faiyajr/75-ISO-Hall-Effect-Keyboard/AST1109MLTRQ_MAL.step

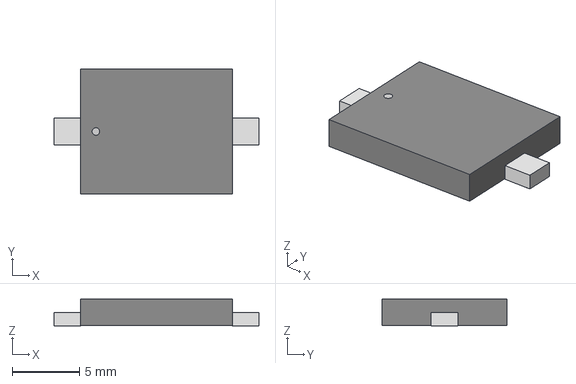
[picture p1: CAD file, 2026-01-05]
AST1109MLTRQ_MAL.step
15.3 x 9.30 x 2.01 mm
