faiyajr/75-ISO-Hall-Effect-Keyboard/Stabilizer - close.STEP

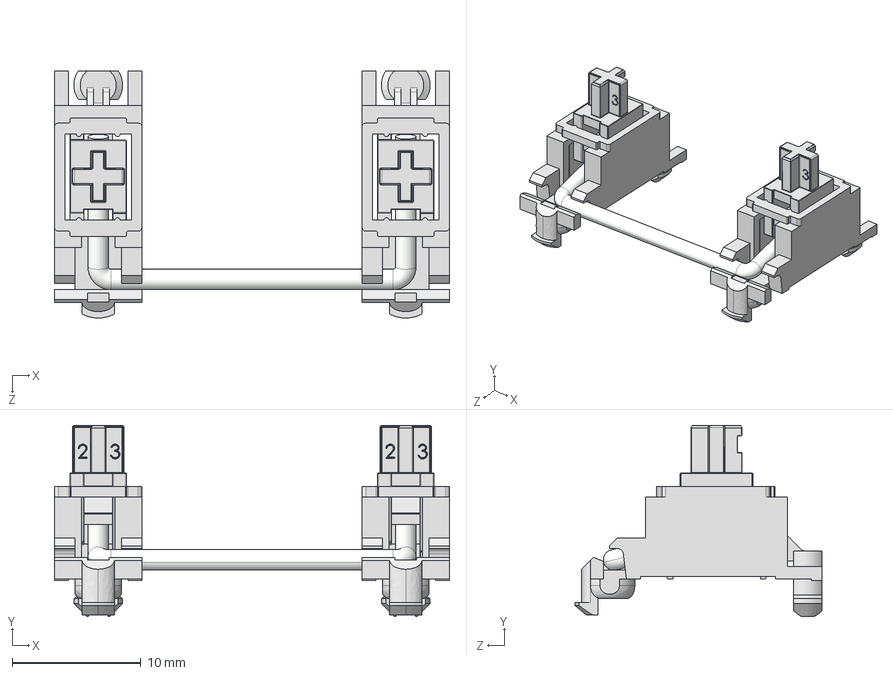
[picture p2: CAD file, 2026-01-05]
Stabilizer - close.STEP
30.7 x 14.9 x 19.2 mm
mx Stabilizer base 16828 x 2
mx Stabilizer key 16828 x 2
metal stick 16828
