faiyajr/75-ISO-Hall-Effect-Keyboard/HCM1206X.stp

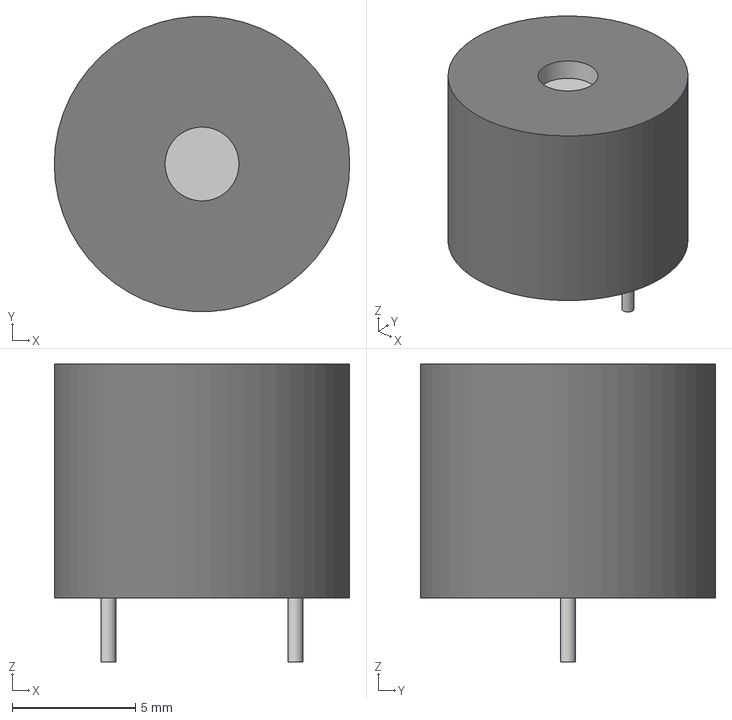
[picture p3: CAD file, 2026-01-05]
HCM1206X.stp
12.0 x 12.0 x 12.1 mm
