faiyajr/75-ISO-Hall-Effect-Keyboard/HRO  TYPE-C-31-M-12.step

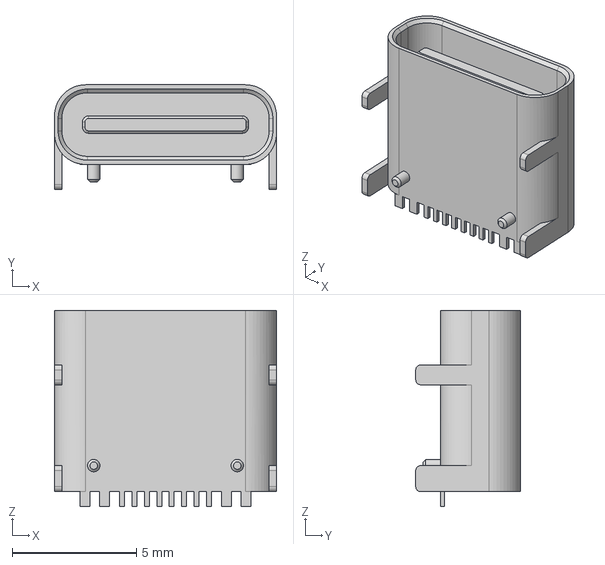
[picture p4: CAD file, 2026-01-05]
HRO TYPE-C-31-M-12.step
8.94 x 4.21 x 7.90 mm
