faiyajr/75-ISO-Hall-Effect-Keyboard/RKJXT1F42001.STEP

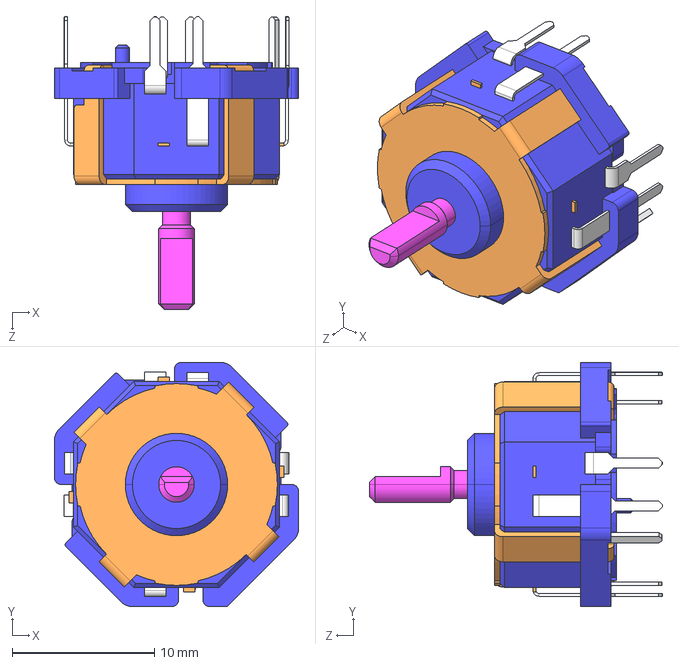
[picture p5: CAD file, 2026-01-05]
RKJXT1F42001.STEP
17.2 x 17.2 x 20.6 mm
