faiyajr/75-ISO-Hall-Effect-Keyboard/128x32-OLED.STEP

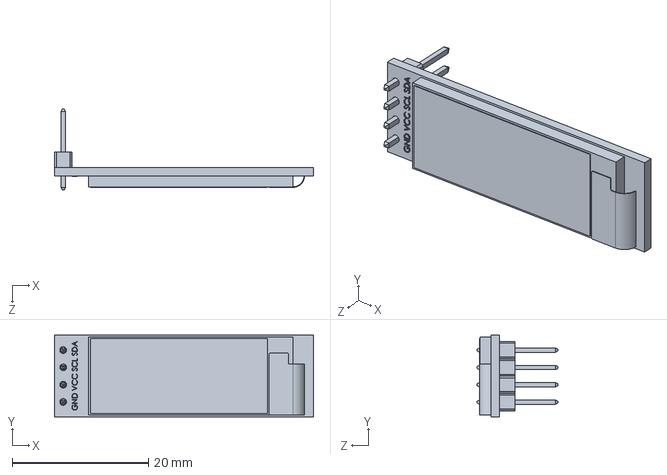
[picture p6: CAD file, 2026-01-05]
128x32-OLED.STEP
38.0 x 12.0 x 11.9 mm
