faiyajr/75-ISO-Hall-Effect-Keyboard/fahajedgecuts.dxf

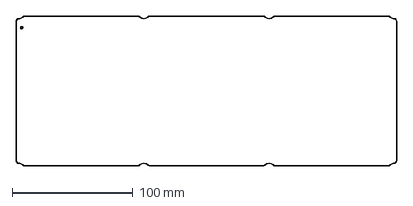
[picture p7: CAD file, 2026-01-05]
fahajedgecuts.dxf
314.3 x 123.8 mm
