faiyajr/75-ISO-Hall-Effect-Keyboard/keyboardcase.SLDPRT

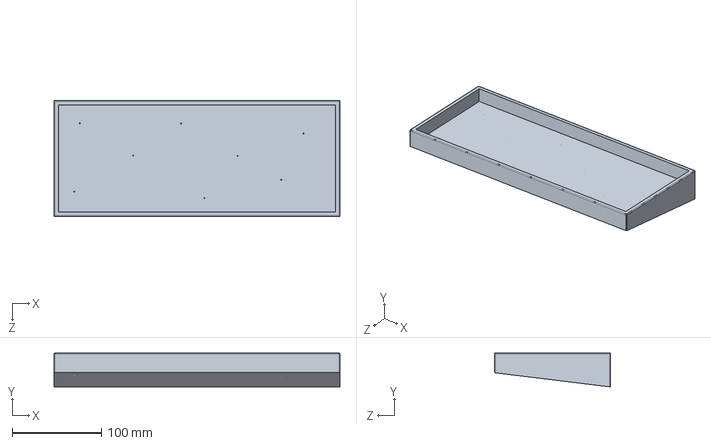
[picture p8: CAD file, 2026-01-05]
keyboardcase.SLDPRT
320.0 x 38.0 x 130.0 mm
