faiyajr/75-ISO-Hall-Effect-Keyboard/48393-0003.stp

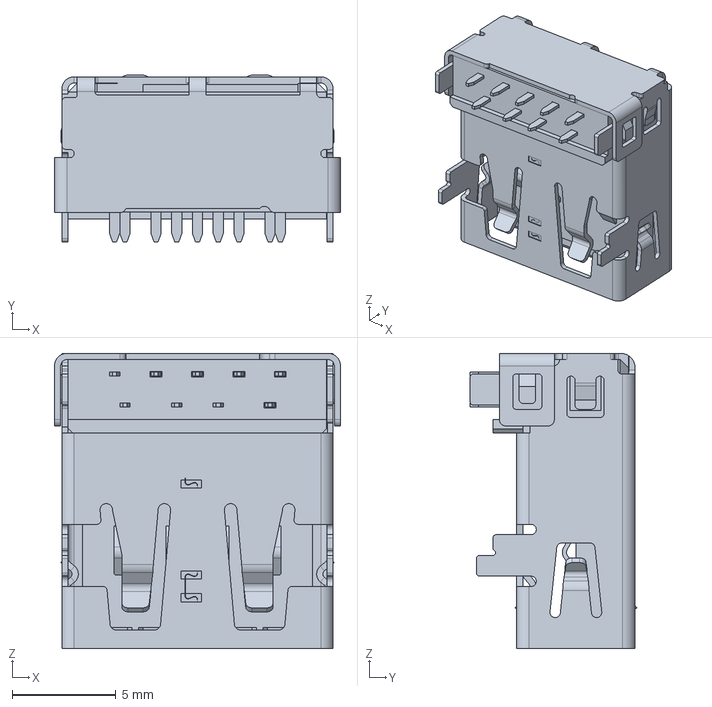
[picture p9: CAD file, 2026-01-05]
48393-0003.stp
13.8 x 8.04 x 14.3 mm
