faiyajr/75-ISO-Hall-Effect-Keyboard/0482580002.step

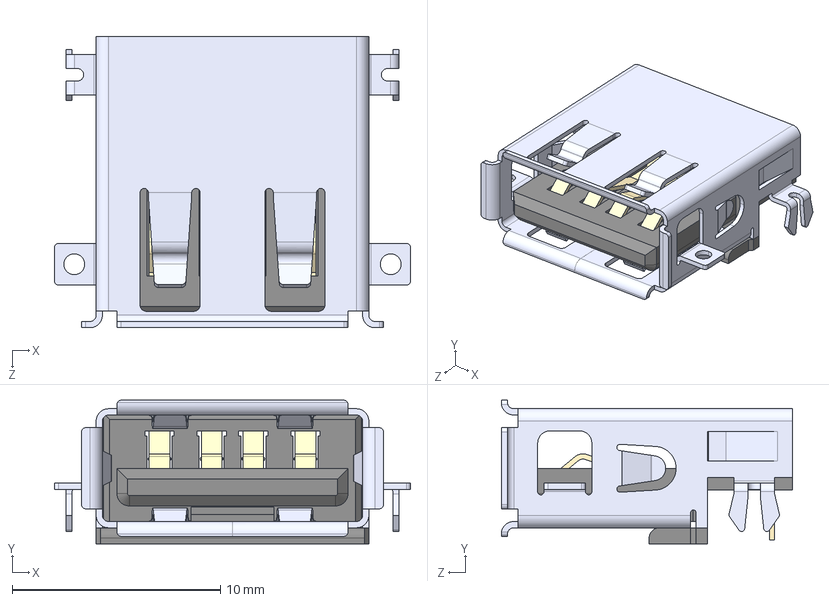
[picture p10: CAD file, 2026-01-05]
0482580002.step
17.1 x 6.90 x 14.0 mm
