faiyajr/75-ISO-Hall-Effect-Keyboard/78171-0004--3DModel-STEP-361473.STEP

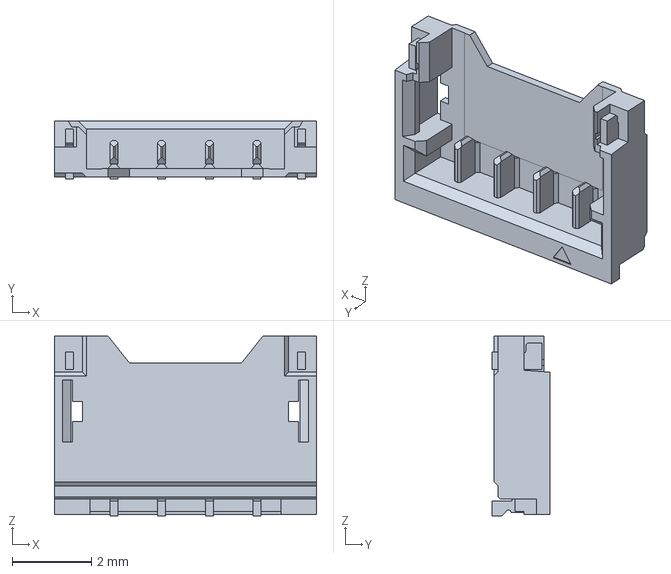
[picture p11: CAD file, 2026-01-05]
78171-0004--3DModel-STEP-361473.STEP
6.60 x 1.45 x 4.53 mm
