faiyajr/75-ISO-Hall-Effect-Keyboard/hall effect keyboard.kicad_sch

## KiCad design hall effect keyboard.kicad_sch (2026-01-05)

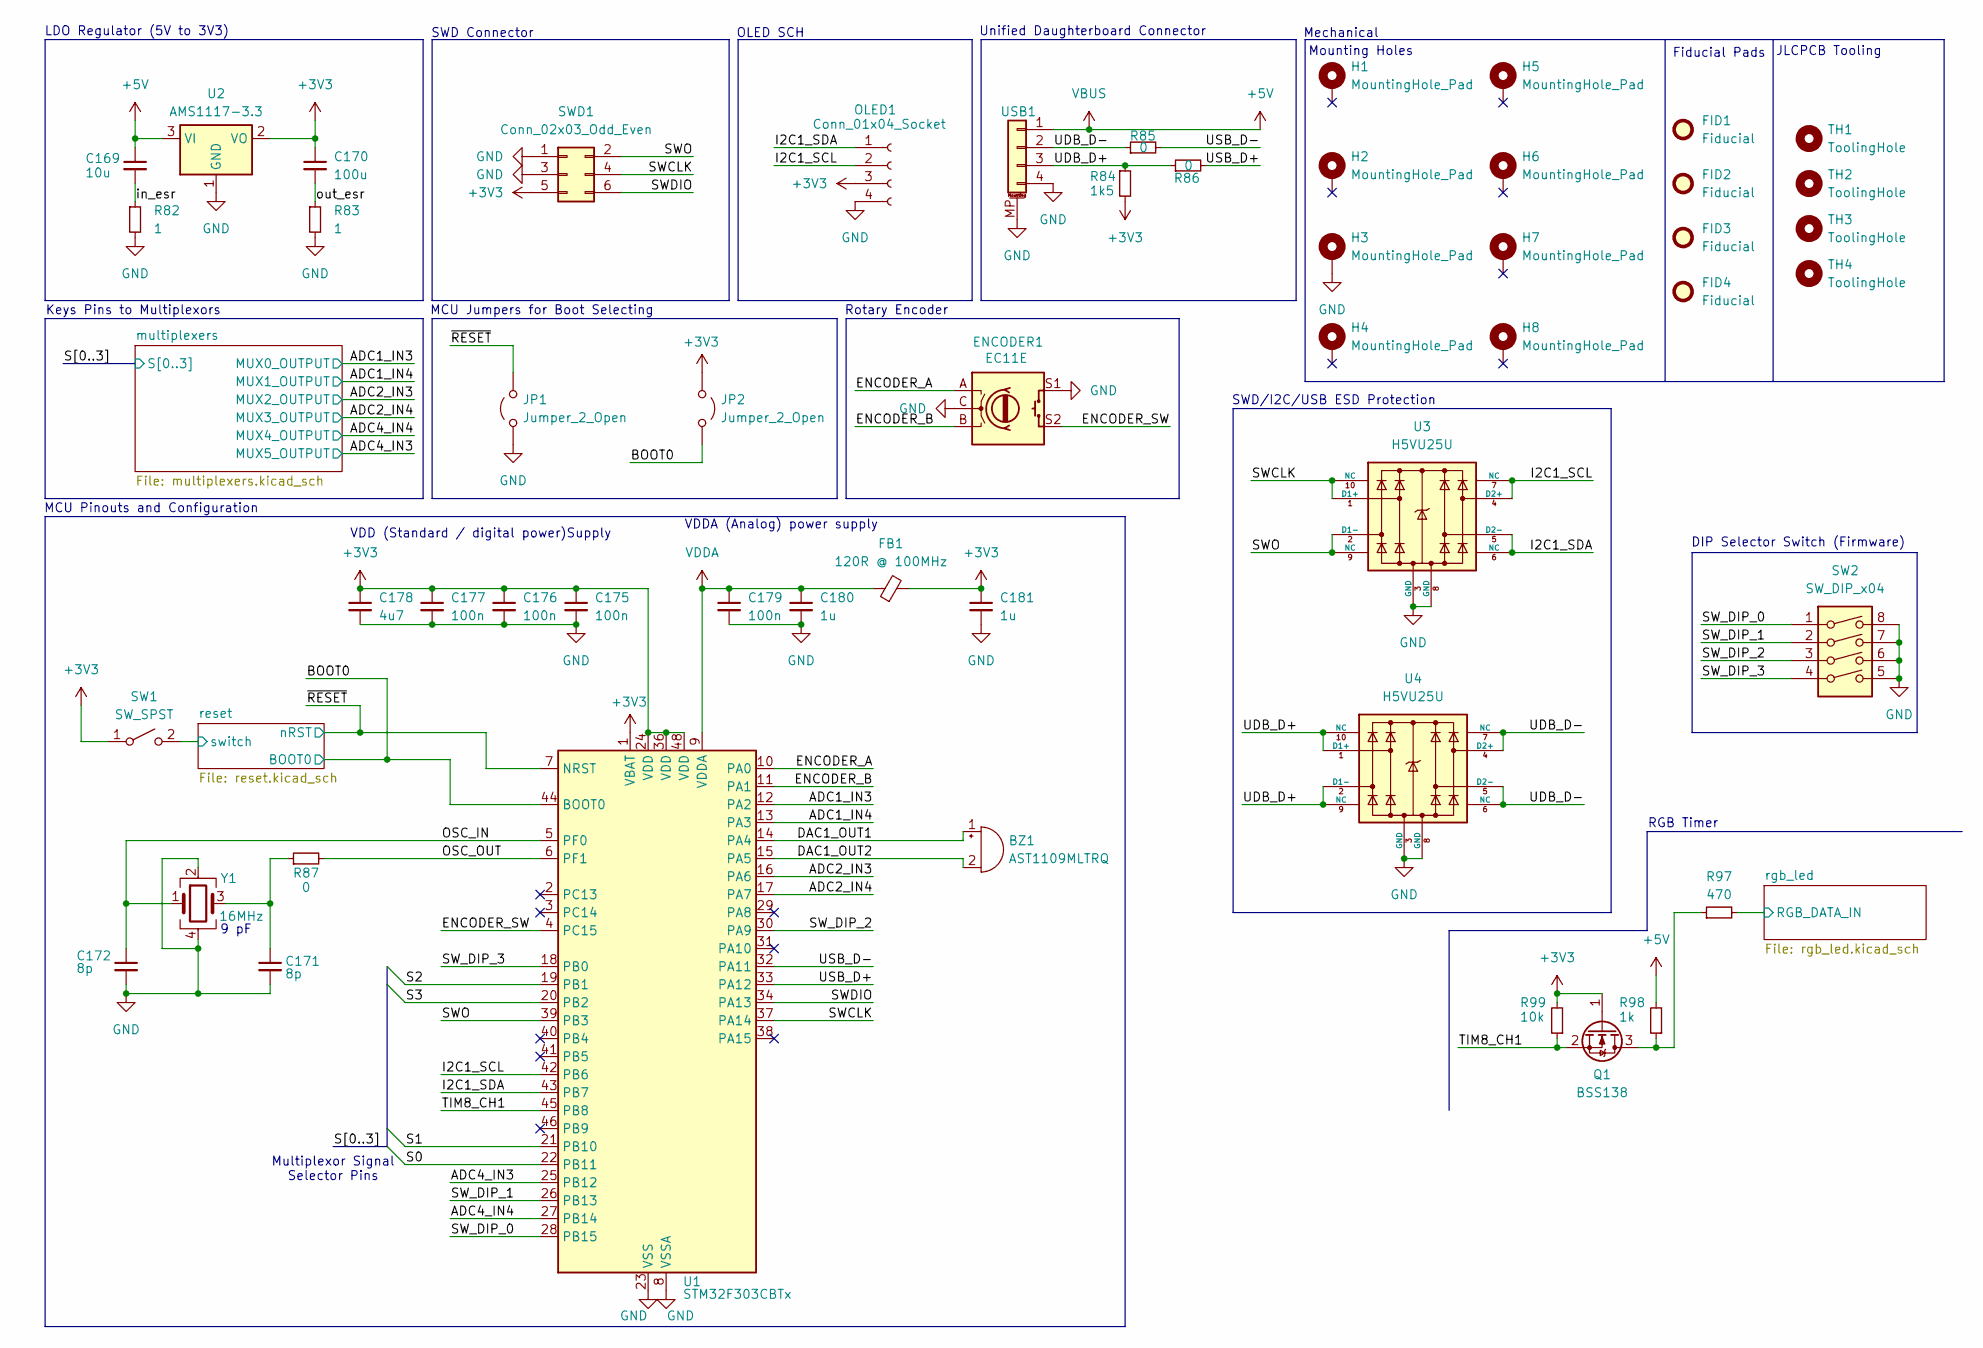
[picture p12: schematic hall effect keyboard.kicad_sch]

Parts:
BZ1: AST1109MLTRQ
C169: 10u; C_1206_3216Metric
C170: 100u; C_1206_3216Metric
C171, C172: 8p; C_0402_1005Metric
C175, C176, C177, C179: 100n; C_0402_1005Metric
C178: 4u7; C_0402_1005Metric
C180, C181: 1u; C_0402_1005Metric
ENCODER1: EC11E; ROT_Alps_EC11E-Switch
FB1: 120R @ 100MHz; L_0805_2012Metric
FID1, FID2, FID3, FID4: Fiducial; Fiducial_1mm_Mask2mm
H1, H2, H3, H4, H5, H6, H7, H8: MountingHole_Pad; 2.2mm hole
JP1, JP2: Jumper_2_Open; PinHeader_1x02_P2.54mm_Vertical
OLED1: Conn_01x04_Socket; OLED Module
Q1: BSS138; SOT-23
R82, R83: 1; R_1206_3216Metric
R84: 1k5; R_0402_1005Metric
R85, R86, R87: 0; R_0603_1608Metric_Pad0.98x0.95mm_HandSolder
R97: 470; R_0402_1005Metric
R98: 1k; R_0402_1005Metric
R99: 10k; R_0402_1005Metric
SW1: SW_SPST; SW_SPST_TL3342
SW2: SW_DIP_x04; SW_DIP_SPSTx04_Slide_6.7x11.72mm_W7.62mm_P2.54mm_LowProfile
SWD1: Conn_02x03_Odd_Even; PinHeader_2x03_P2.54mm_Vertical
TH1, TH2, TH3, TH4: ToolingHole; JLC-Tooling-Hole
U1: STM32F303CBTx; LQFP-48_7x7mm_P0.5mm
U2: AMS1117-3.3; SOT-223-3_TabPin2
U3, U4: H5VU25U; DFN2510; Manufacturer Part Number TPD4E05U06DQAR; LCSC Part Number C138714
USB1: X1224WRS-04-LPV01; PicoEZMate-Reinforced-Alt; Manufacturer Part Number X1224WRS-04-LPV01; LCSC Part Number C528030
Y1: 16MHz; Crystal_SMD_3225-4Pin_3.2x2.5mm

Connections:
+3V3: C170.1, C175.1, C176.1, C177.1, C178.1, C181.1, FB1.2, JP2.1 (A), OLED1.3, Q1.1 (G), R84.2, R99.2, SW1.1 (A), SWD1.5, U1.1 (VBAT), U1.24 (VDD), U1.36 (VDD), U1.48 (VDD), U2.2 (VO)
+5V: C169.1, R98.2, U2.3 (VI), USB1.1
ADC1_IN3: U1.12 (PA2)
ADC1_IN4: U1.13 (PA3)
ADC2_IN3: U1.16 (PA6)
ADC2_IN4: U1.17 (PA7)
ADC4_IN3: U1.25 (PB12)
ADC4_IN4: U1.27 (PB14)
BOOT0: JP2.2 (B), U1.44 (BOOT0)
DAC1_OUT1: BZ1.1 (+), U1.14 (PA4)
DAC1_OUT2: BZ1.2 (-), U1.15 (PA5)
ENCODER_A: ENCODER1.A, U1.10 (PA0)
ENCODER_B: ENCODER1.B, U1.11 (PA1)
ENCODER_SW: ENCODER1.S2, U1.4 (PC15)
GND: C171.2, C172.2, C175.2, C176.2, C177.2, C178.2, C179.2, C180.2, C181.2, ENCODER1.C, ENCODER1.S1, H3.1, JP1.1 (A), OLED1.4, R82.2, R83.2, SW2.5, SW2.6, SW2.7, SW2.8, SWD1.1, SWD1.3, U1.8 (VSSA), U1.23 (VSS), U1.35 (VSS), U1.47 (VSS), U2.1 (GND), U3.3 (GND), U3.8 (GND), U4.3 (GND), U4.8 (GND), USB1.4, USB1.MP (MountPin), Y1.2, Y1.4
I2C1_SCL: OLED1.2, U1.42 (PB6), U3.4 (D2+), U3.7 (NC)
I2C1_SDA: OLED1.1, U1.43 (PB7), U3.5 (D2-), U3.6 (NC)
unnamed: C171.1, R87.1, Y1.3
unnamed: Q1.3 (D), R97.1, R98.1
OSC_IN: C172.1, U1.5 (PF0), Y1.1
OSC_OUT: R87.2, U1.6 (PF1)
RGB_DATA_IN: R97.2
S0: U1.22 (PB11)
S1: U1.21 (PB10)
S2: U1.19 (PB1)
S3: U1.20 (PB2)
SWCLK: SWD1.4, U1.37 (PA14), U3.1 (D1+), U3.10 (NC)
SWDIO: SWD1.6, U1.34 (PA13)
SWO: SWD1.2, U1.39 (PB3), U3.2 (D1-), U3.9 (NC)
SW_DIP_0: SW2.1, U1.28 (PB15)
SW_DIP_1: SW2.2, U1.26 (PB13)
SW_DIP_2: SW2.3, U1.30 (PA9)
SW_DIP_3: SW2.4, U1.18 (PB0)
TIM8_CH1: Q1.2 (S), R99.1, U1.45 (PB8)
UDB_D+: R84.1, R86.1, U4.1 (D1+), U4.2 (D1-), U4.9 (NC), U4.10 (NC), USB1.3
UDB_D-: R85.1, U4.4 (D2+), U4.5 (D2-), U4.6 (NC), U4.7 (NC), USB1.2
USB_D+: R86.2, U1.33 (PA12)
USB_D-: R85.2, U1.32 (PA11)
VDDA: C179.1, C180.1, FB1.1, U1.9 (VDDA)
in_esr: C169.2, R82.1
out_esr: C170.2, R83.1
switch: SW1.2 (B)
~RESET: JP1.2 (B), U1.7 (NRST)

Notes on the sheet:
MCU Jumpers for Boot Selecting
9 pF
MCU Pinouts and Configuration
Multiplexor Signal Selector Pins
VDDA (Analog) power supply
Mechanical
SWD/I2C/USB ESD Protection
Rotary Encoder
OLED SCH
JLCPCB Tooling
LDO Regulator (5V to 3V3)
Mounting Holes
Keys Pins to Multiplexors
DIP Selector Switch (Firmware)
RGB Timer
SWD Connector
Unified Daughterboard Connector
Fiducial Pads
VDD (Standard / digital power)Supply
