faiyajr/75-ISO-Hall-Effect-Keyboard/keys.kicad_sch

## KiCad design keys.kicad_sch (2026-01-05)

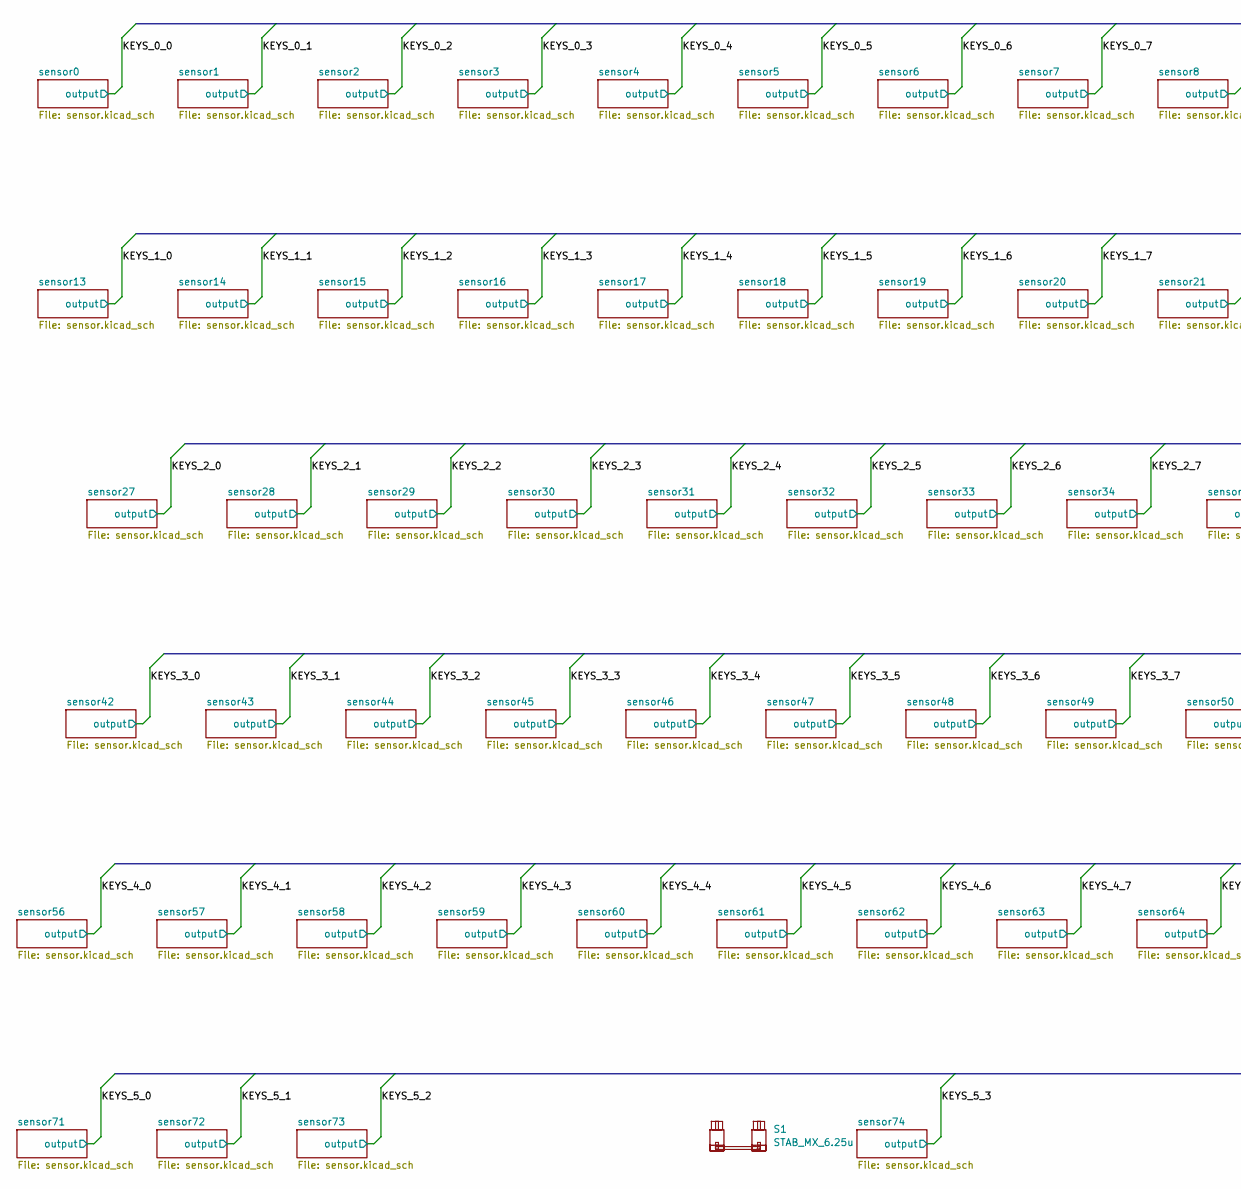
[picture p13: schematic keys.kicad_sch, part in row 1, column 1]

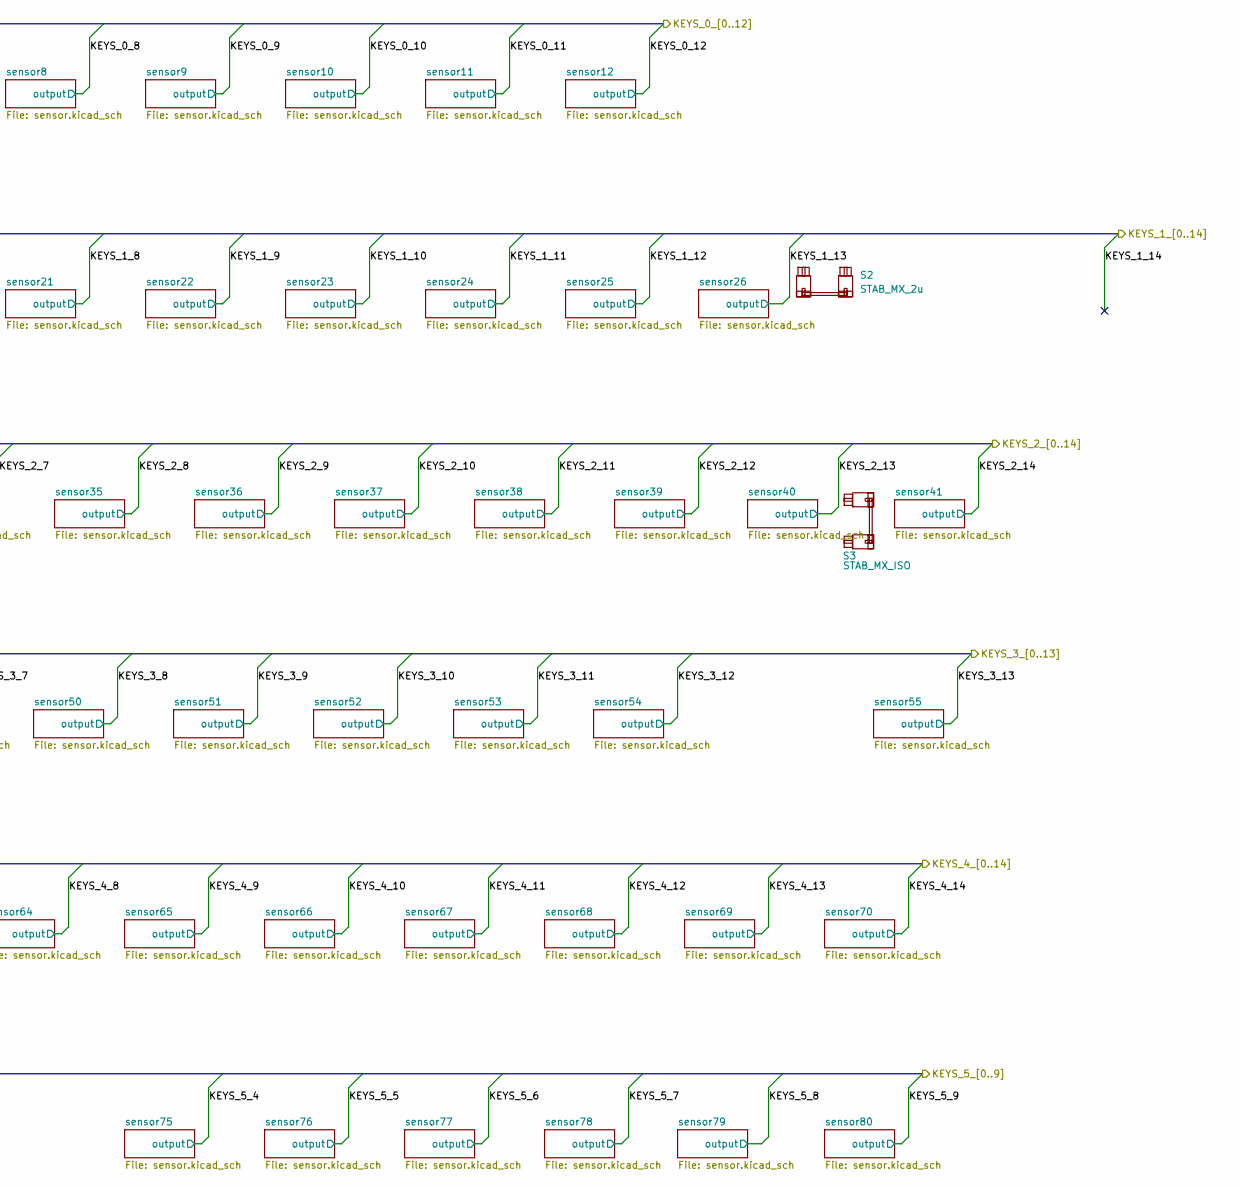
[picture p14: schematic keys.kicad_sch, part in row 1, column 2]

Parts:
S1: STAB_MX_6.25u; STAB_MX_P_6.25u
S2: STAB_MX_2u; STAB_MX_P_2u
S3: STAB_MX_ISO; STAB_MX_P_ISO
