faiyajr/75-ISO-Hall-Effect-Keyboard/multiplexers.kicad_sch

## KiCad design multiplexers.kicad_sch (2026-01-05)

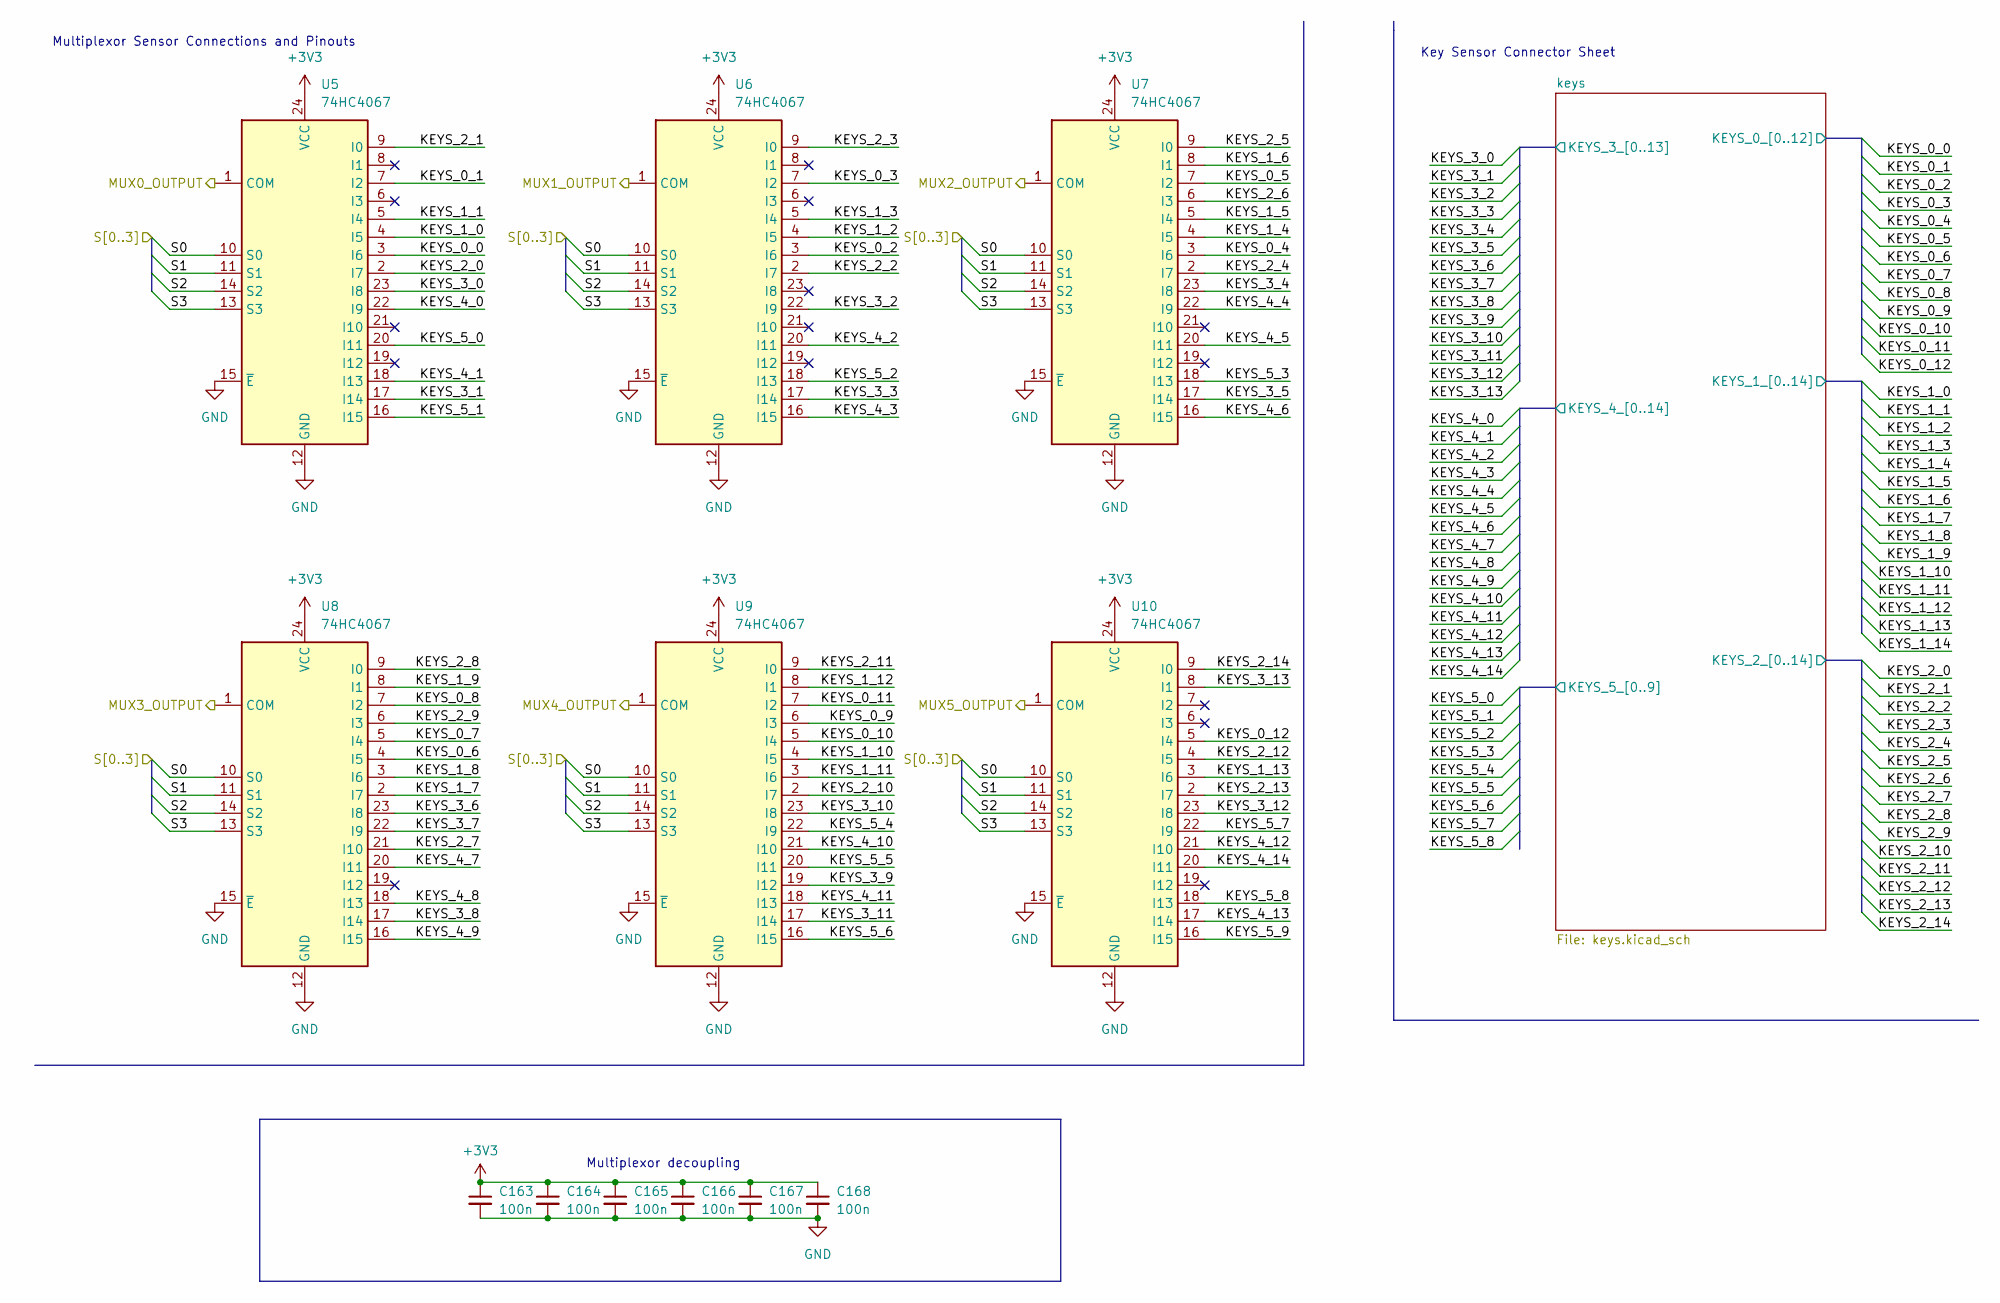
[picture p15: schematic multiplexers.kicad_sch]

Parts:
C163, C164, C165, C166, C167, C168: 100n; C_0402_1005Metric
U5, U6, U7, U8, U9, U10: 74HC4067; TSSOP-24_4.4x7.8mm_P0.65mm

Connections:
+3V3: C163.1, C164.1, C165.1, C166.1, C167.1, C168.1, U5.24 (VCC), U6.24 (VCC), U7.24 (VCC), U8.24 (VCC), U9.24 (VCC), U10.24 (VCC)
GND: C163.2, C164.2, C165.2, C166.2, C167.2, C168.2, U5.12 (GND), U5.15 (~E), U6.12 (GND), U6.15 (~E), U7.12 (GND), U7.15 (~E), U8.12 (GND), U8.15 (~E), U9.12 (GND), U9.15 (~E), U10.12 (GND), U10.15 (~E)
KEYS_0_0: U5.3 (I6)
KEYS_0_1: U5.7 (I2)
KEYS_0_2: U6.3 (I6)
KEYS_0_3: U6.7 (I2)
KEYS_0_4: U7.3 (I6)
KEYS_0_5: U7.7 (I2)
KEYS_0_6: U8.4 (I5)
KEYS_0_7: U8.5 (I4)
KEYS_0_8: U8.7 (I2)
KEYS_0_9: U9.6 (I3)
KEYS_0_10: U9.5 (I4)
KEYS_0_11: U9.7 (I2)
KEYS_0_12: U10.5 (I4)
KEYS_1_0: U5.4 (I5)
KEYS_1_1: U5.5 (I4)
KEYS_1_2: U6.4 (I5)
KEYS_1_3: U6.5 (I4)
KEYS_1_4: U7.4 (I5)
KEYS_1_5: U7.5 (I4)
KEYS_1_6: U7.8 (I1)
KEYS_1_7: U8.2 (I7)
KEYS_1_8: U8.3 (I6)
KEYS_1_9: U8.8 (I1)
KEYS_1_10: U9.4 (I5)
KEYS_1_11: U9.3 (I6)
KEYS_1_12: U9.8 (I1)
KEYS_1_13: U10.3 (I6)
KEYS_2_0: U5.2 (I7)
KEYS_2_1: U5.9 (I0)
KEYS_2_2: U6.2 (I7)
KEYS_2_3: U6.9 (I0)
KEYS_2_4: U7.2 (I7)
KEYS_2_5: U7.9 (I0)
KEYS_2_6: U7.6 (I3)
KEYS_2_7: U8.21 (I10)
KEYS_2_8: U8.9 (I0)
KEYS_2_9: U8.6 (I3)
KEYS_2_10: U9.2 (I7)
KEYS_2_11: U9.9 (I0)
KEYS_2_12: U10.4 (I5)
KEYS_2_13: U10.2 (I7)
KEYS_2_14: U10.9 (I0)
KEYS_3_0: U5.23 (I8)
KEYS_3_1: U5.17 (I14)
KEYS_3_2: U6.22 (I9)
KEYS_3_3: U6.17 (I14)
KEYS_3_4: U7.23 (I8)
KEYS_3_5: U7.17 (I14)
KEYS_3_6: U8.23 (I8)
KEYS_3_7: U8.22 (I9)
KEYS_3_8: U8.17 (I14)
KEYS_3_9: U9.19 (I12)
KEYS_3_10: U9.23 (I8)
KEYS_3_11: U9.17 (I14)
KEYS_3_12: U10.23 (I8)
KEYS_3_13: U10.8 (I1)
KEYS_4_0: U5.22 (I9)
KEYS_4_1: U5.18 (I13)
KEYS_4_2: U6.20 (I11)
KEYS_4_3: U6.16 (I15)
KEYS_4_4: U7.22 (I9)
KEYS_4_5: U7.20 (I11)
KEYS_4_6: U7.16 (I15)
KEYS_4_7: U8.20 (I11)
KEYS_4_8: U8.18 (I13)
KEYS_4_9: U8.16 (I15)
KEYS_4_10: U9.21 (I10)
KEYS_4_11: U9.18 (I13)
KEYS_4_12: U10.21 (I10)
KEYS_4_13: U10.17 (I14)
KEYS_4_14: U10.20 (I11)
KEYS_5_0: U5.20 (I11)
KEYS_5_1: U5.16 (I15)
KEYS_5_2: U6.18 (I13)
KEYS_5_3: U7.18 (I13)
KEYS_5_4: U9.22 (I9)
KEYS_5_5: U9.20 (I11)
KEYS_5_6: U9.16 (I15)
KEYS_5_7: U10.22 (I9)
KEYS_5_8: U10.18 (I13)
KEYS_5_9: U10.16 (I15)
MUX0_OUTPUT: U5.1 (COM)
MUX1_OUTPUT: U6.1 (COM)
MUX2_OUTPUT: U7.1 (COM)
MUX3_OUTPUT: U8.1 (COM)
MUX4_OUTPUT: U9.1 (COM)
MUX5_OUTPUT: U10.1 (COM)
S0: U5.10 (S0), U6.10 (S0), U7.10 (S0), U8.10 (S0), U9.10 (S0), U10.10 (S0)
S1: U5.11 (S1), U6.11 (S1), U7.11 (S1), U8.11 (S1), U9.11 (S1), U10.11 (S1)
S2: U5.14 (S2), U6.14 (S2), U7.14 (S2), U8.14 (S2), U9.14 (S2), U10.14 (S2)
S3: U5.13 (S3), U6.13 (S3), U7.13 (S3), U8.13 (S3), U9.13 (S3), U10.13 (S3)

Notes on the sheet:
Multiplexor Sensor Connections and Pinouts
Multiplexor decoupling
Key Sensor Connector Sheet
