faiyajr/75-ISO-Hall-Effect-Keyboard/reset.kicad_sch

## KiCad design reset.kicad_sch (2026-01-05)

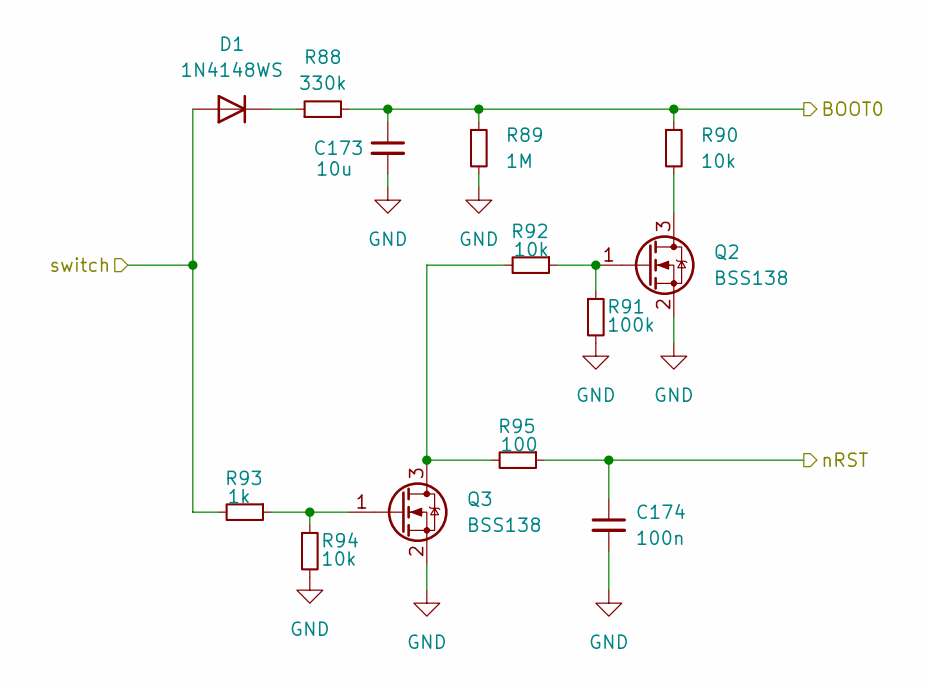
[picture p16: schematic reset.kicad_sch]

Parts:
C173: 10u; C_1206_3216Metric
C174: 100n; C_0402_1005Metric
D1: 1N4148WS; D_SOD-323
Q2, Q3: BSS138; SOT-23
R88: 330k; R_0603_1608Metric
R89: 1M; R_0402_1005Metric
R90, R92, R94: 10k; R_0402_1005Metric
R91: 100k; R_0402_1005Metric
R93: 1k; R_0402_1005Metric
R95: 100; R_0402_1005Metric

Connections:
BOOT0: C173.1, R88.2, R89.1, R90.1
GND: C173.2, C174.2, Q2.2 (S), Q3.2 (S), R89.2, R91.2, R94.2
unnamed: D1.1 (K), R88.1
unnamed: Q2.1 (G), R91.1, R92.1
unnamed: Q2.3 (D), R90.2
unnamed: Q3.1 (G), R93.1, R94.1
unnamed: Q3.3 (D), R92.2, R95.2
nRST: C174.1, R95.1
switch: D1.2 (A), R93.2
