faiyajr/75-ISO-Hall-Effect-Keyboard/rgb_led.kicad_sch

## KiCad design rgb_led.kicad_sch (2026-01-05)

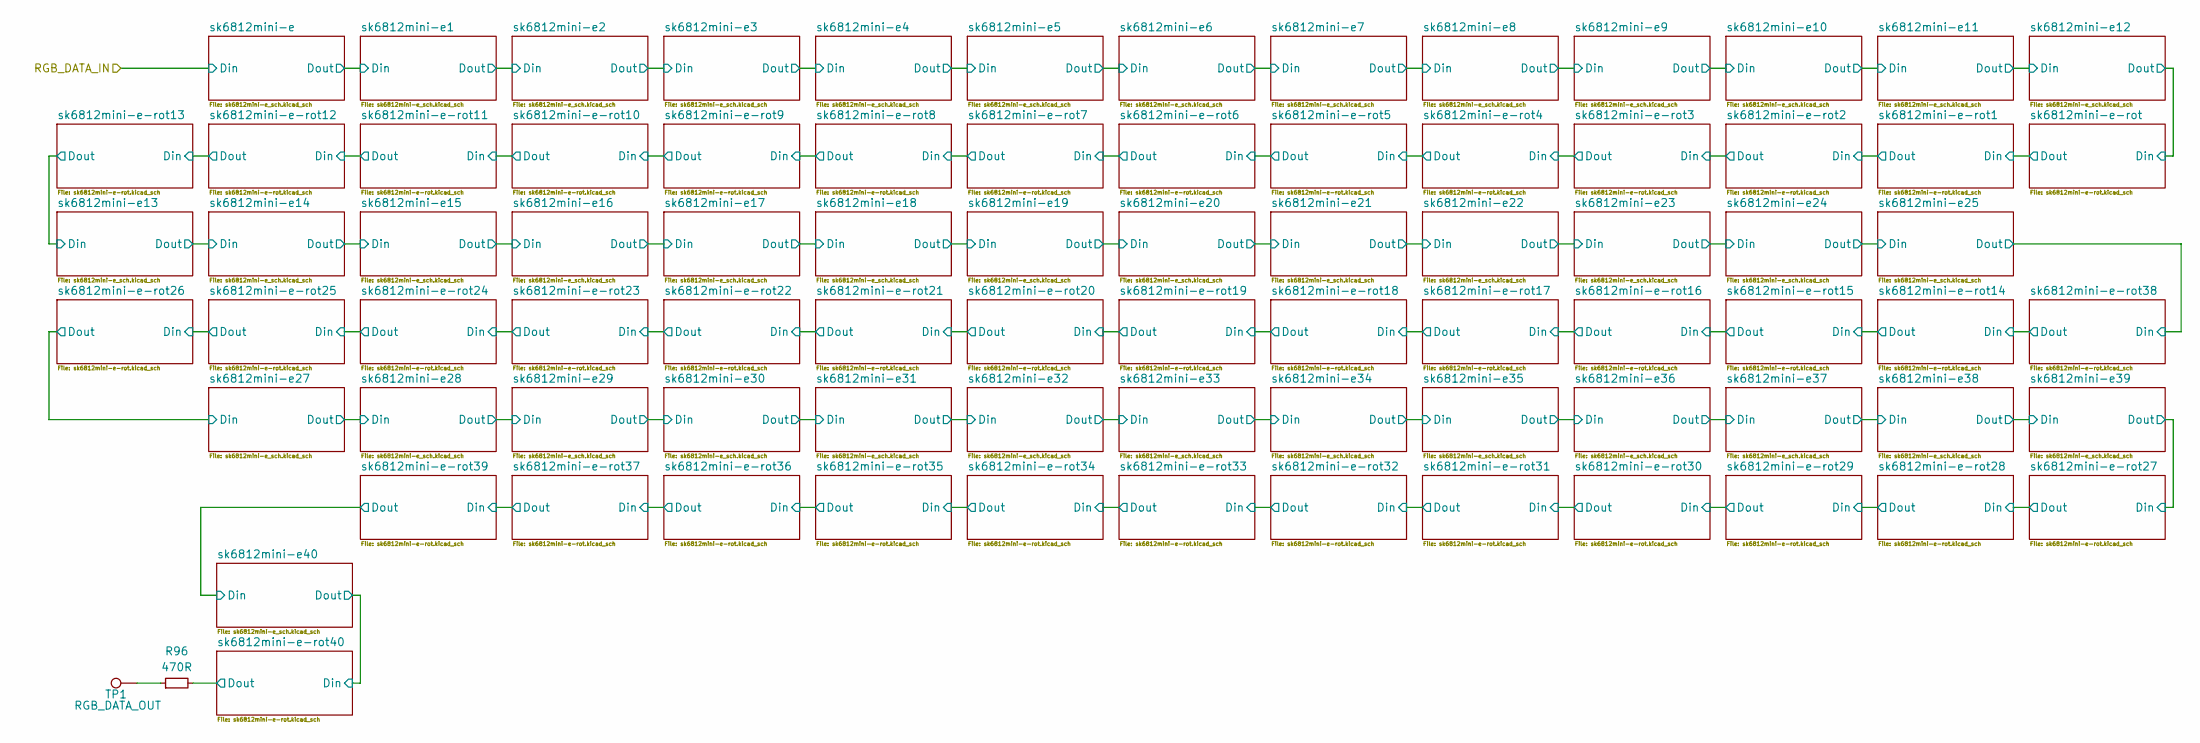
[picture p17: schematic rgb_led.kicad_sch]

Parts:
R96: 470R; R_0402_1005Metric
TP1: RGB_DATA_OUT; TestPoint_Pad_D1.5mm

Connections:
Dout: R96.2
unnamed: R96.1, TP1.1
