faiyajr/75-ISO-Hall-Effect-Keyboard/sensor.kicad_sch

## KiCad design sensor.kicad_sch (2026-01-05)

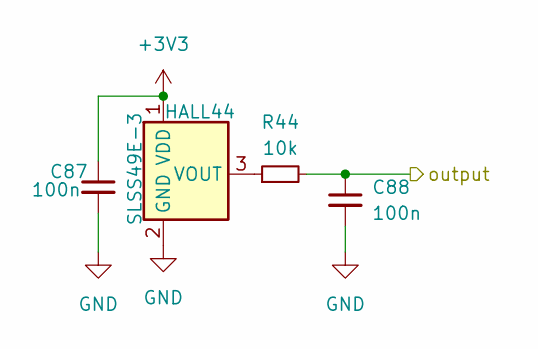
[picture p18: schematic sensor.kicad_sch]

Parts:
C87, C88: 100n; C_0402_1005Metric
HALL44: SLSS49E-3; SLSS49E-3 with MX holes
R44: 10k; R_0402_1005Metric

Connections:
+3V3: C87.1, HALL44.1 (VDD)
GND: C87.2, C88.2, HALL44.2 (GND)
unnamed: HALL44.3 (VOUT), R44.1
output: C88.1, R44.2
