faiyajr/75-ISO-Hall-Effect-Keyboard/sk6812mini-e-rot.kicad_sch

## KiCad design sk6812mini-e-rot.kicad_sch (2026-01-05)

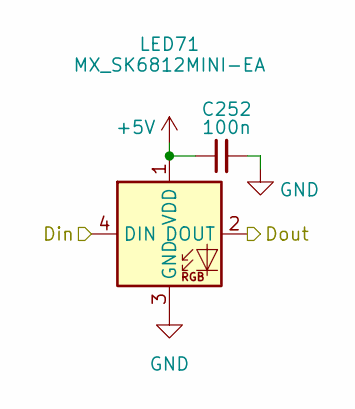
[picture p19: schematic sk6812mini-e-rot.kicad_sch]

Parts:
C252: 100n; C_0402_1005Metric
LED71: MX_SK6812MINI-EA; SK 6812 MINI-EA

Connections:
+5V: C252.1, LED71.1 (VDD)
Din: LED71.4 (DIN)
Dout: LED71.2 (DOUT)
GND: C252.2, LED71.3 (GND)
