faiyajr/75-ISO-Hall-Effect-Keyboard/sk6812mini-e_sch.kicad_sch

## KiCad design sk6812mini-e_sch.kicad_sch (2026-01-05)

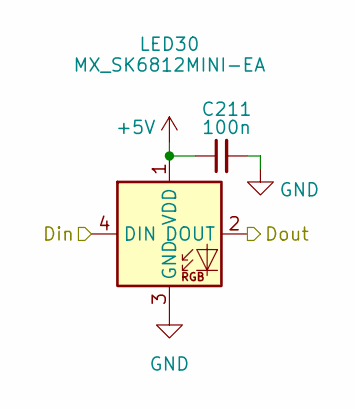
[picture p20: schematic sk6812mini-e_sch.kicad_sch]

Parts:
C211: 100n; C_0402_1005Metric
LED30: MX_SK6812MINI-EA; SK 6812 MINI-EA

Connections:
+5V: C211.1, LED30.1 (VDD)
Din: LED30.4 (DIN)
Dout: LED30.2 (DOUT)
GND: C211.2, LED30.3 (GND)
