faiyajr/75-ISO-Hall-Effect-Keyboard/(commit log)

2026-01-05 Update README with project details and features
    Added detailed project description and features for the 75% ISO Hall-Effect Keyboard.
2026-01-05 Expand README with project details and features
    Added detailed project description, features, system overview, power architecture, signal integrity, interfaces, mechanical design, and firmware link.
2026-01-05 All files for this project
    [fahajedgecuts.dxf, hall effect keyboard.kicad_sch, keyboardcase.SLDPRT, keys.kicad_sch, multiplexers.kicad_sch, reset.kicad_sch, rgb_led.kicad_sch, sensor.kicad_sch]
2026-01-05 all necessary 3d shapes for components of pcb
    [0482580002.step, 128x32-OLED.STEP, 48393-0003.stp, 78171-0004--3DModel-STEP-361473.STEP, AST1109MLTRQ_MAL.step, HCM1206X.stp, HRO TYPE-C-31-M-12.step, RKJXT1F42001.STEP]
2026-01-08 Add PCBWay sponsorship details to README
    Added sponsorship information for PCBWay, highlighting their support and services for PCB fabrication.
